rjeans/rotexign/analysis/smoothed_timing_curves.png

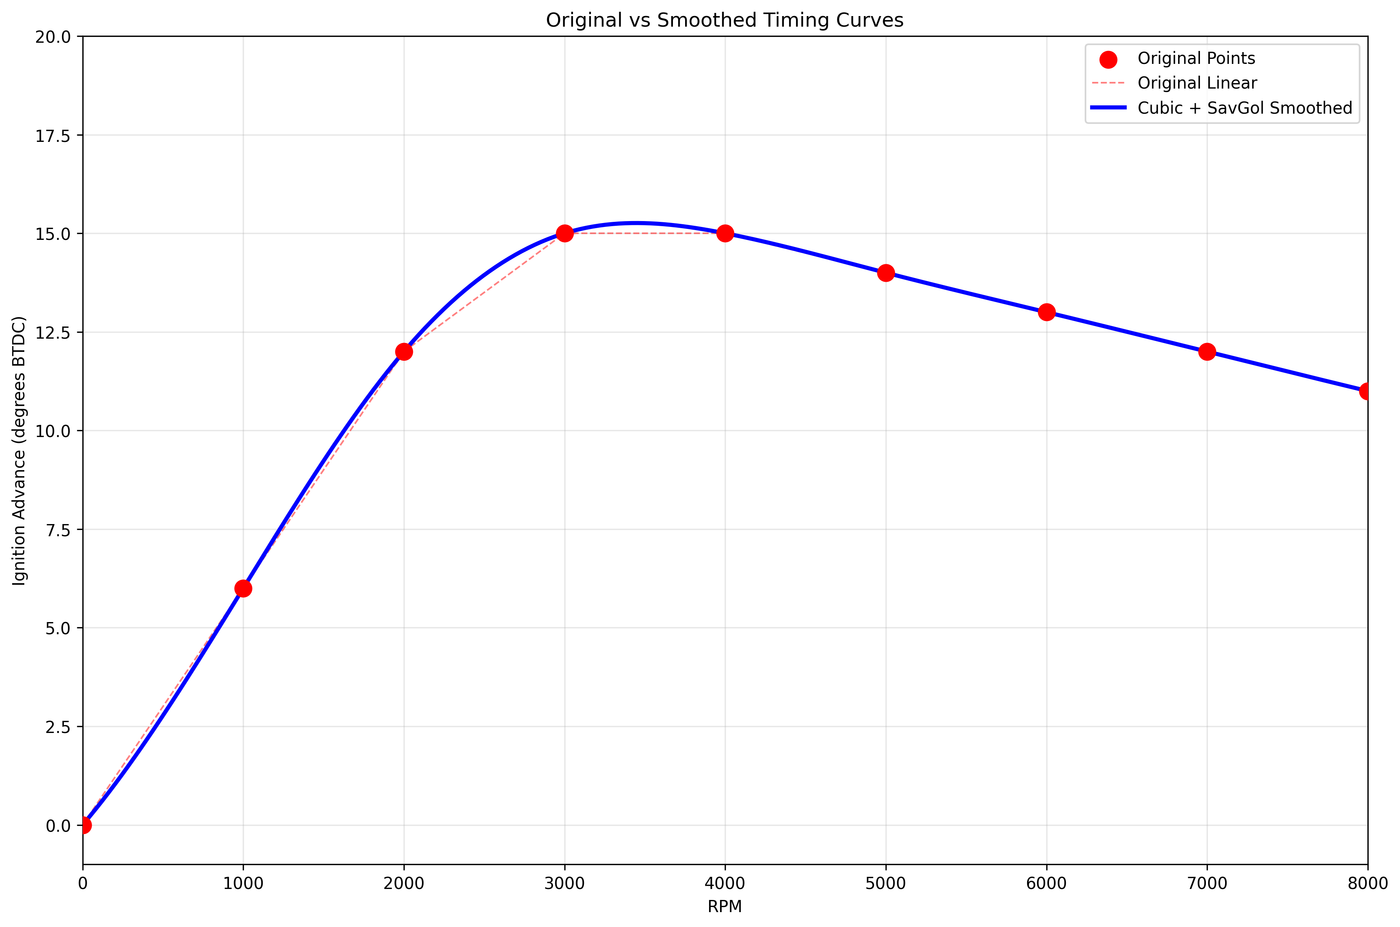
analysis/smoothed_timing_curves.png
