rjeans/rotexign/analysis/plot_data_verification.csv

rpm | advance_degrees | data_source
800 | 4.69 | plot_data
800 | 4.69 | plot_data
800 | 4.69 | plot_data
800 | 4.69 | plot_data
800 | 4.69 | plot_data
800 | 4.69 | plot_data
800 | 4.69 | plot_data
800 | 4.69 | plot_data
800 | 4.69 | plot_data
800 | 4.69 | plot_data
800 | 4.69 | plot_data
800 | 4.69 | plot_data
800 | 4.69 | plot_data
800 | 4.69 | plot_data
800 | 4.69 | plot_data
800 | 4.69 | plot_data
800 | 4.69 | plot_data
800 | 4.69 | plot_data
800 | 4.69 | plot_data
800 | 4.69 | plot_data
800 | 4.69 | plot_data
800 | 4.69 | plot_data
800 | 4.69 | plot_data
800 | 4.69 | plot_data
800 | 4.69 | plot_data
800 | 4.69 | plot_data
800 | 4.69 | plot_data
800 | 4.69 | plot_data
800 | 4.68 | plot_data
800 | 4.69 | plot_data
800 | 4.69 | plot_data
800 | 4.69 | plot_data
800 | 4.69 | plot_data
800 | 4.68 | plot_data
800 | 4.69 | plot_data
800 | 4.69 | plot_data
800 | 4.69 | plot_data
800 | 4.69 | plot_data
800 | 4.69 | plot_data
800 | 4.69 | plot_data
800 | 4.69 | plot_data
800 | 4.68 | plot_data
800 | 4.69 | plot_data
800 | 4.69 | plot_data
800 | 4.69 | plot_data
800 | 4.69 | plot_data
800 | 4.69 | plot_data
800 | 4.69 | plot_data
800 | 4.69 | plot_data
800 | 4.68 | plot_data
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
