rjeans/rotexign/analysis/timing_analyzer.py

#!/usr/bin/env python3
"""
VCD Timing Analyzer with Comprehensive Plotting
Measures trigger falling edge to spark falling edge timing
Generates timing curves, waveforms, and analysis plots with scatter points
"""
import sys
import csv
import numpy as np
import matplotlib
matplotlib.use('Agg')  # Use non-interactive backend
import matplotlib.pyplot as plt
from typing import List, Tuple, Dict

# Signal mappings for VCD parsing
# Updated to reflect inverted spark logic: LOW = dwell start, HIGH = spark
SIGNAL_MAPPINGS = {
    '0#': 'trigger_fall',
    '1#': 'trigger_rise',
    '0$': 'dwell_start',   # LOW = dwell start (coil charging)
    '1$': 'spark_fire',    # HIGH = spark (coil fires)
    '0!': 'trigger_fall',  # Legacy
    '1!': 'trigger_rise',  # Legacy
    '0"': 'dwell_start',   # Legacy - now dwell start
    '1"': 'spark_fire'     # Legacy - now spark fire
}

def parse_vcd_file(vcd_file: str) -> List[Tuple[int, str]]:
    """
    Parse the VCD file and extract signal changes.

    Args:
        vcd_file: Path to the VCD file.

    Returns:
        A list of tuples containing the time and event type.
    """
    signal_changes = []
    current_time = 0

    with open(vcd_file, 'r') as f:
        for line in f:
            line = line.strip()
            if line.startswith('#'):
                current_time = int(line[1:])
            elif line in SIGNAL_MAPPINGS:
                signal_changes.append((current_time, SIGNAL_MAPPINGS[line]))

    return signal_changes

def find_previous_event(signal_changes: List[Tuple[int, str]], start_index: int, event_type: str) -> int:
    """
    Find the most recent event of a given type before a specific index.

    Args:
        signal_changes: List of signal changes.
        start_index: Index to start searching backward from.
        event_type: The event type to search for.

    Returns:
        The time of the most recent event, or None if not found.
    """
    for j in range(start_index - 1, -1, -1):
        if signal_changes[j][1] == event_type:
            return signal_changes[j][0]
    return None

def calculate_rpm(period_ns: int, pulses_per_revolution: int = 2) -> float:
    """
    Calculate RPM from a period in nanoseconds.

    Args:
        period_ns: The period in nanoseconds.
        pulses_per_revolution: Number of pulses per revolution (default: 2).

    Returns:
        The calculated RPM.
    """
    period_us = period_ns / 1000.0
    return (60_000_000.0 / period_us) / pulses_per_revolution

def find_corresponding_dwell(signal_changes: List[Tuple[int, str]], spark_idx: int, spark_time: int) -> float:
    """
    Find the dwell start corresponding to a given spark event.

    Args:
        signal_changes: List of signal changes.
        spark_idx: Index of the spark event.
        spark_time: Time of the spark event.

    Returns:
        The dwell time in microseconds, or None if not found.
    """
    for k in range(spark_idx - 1, -1, -1):
        check_time, check_event = signal_changes[k]
        if spark_time - check_time > 200000000:  # Stop if too far back (200ms)
            break
        if check_event == 'dwell_start':
            spark_between = any(
                signal_changes[m][1] == 'spark_fire'
                for m in range(k + 1, spark_idx)
            )
            if not spark_between:
                return (spark_time - check_time) / 1000.0
    return None

def find_dwell_for_trigger(signal_changes: List[Tuple[int, str]], trigger_idx: int, spark_idx: int, spark_time: int, trigger_time: int) -> float:
    """
    Find dwell start after trigger, looking forward to next period.
    
    Args:
        signal_changes: List of signal changes.
        trigger_idx: Index of the trigger event.
        spark_idx: Index of the spark event.
        spark_time: Time of the spark event.
        trigger_time: Time of the trigger event.
    
    Returns:
        The dwell time in microseconds, or None if not found.
    """
    # Calculate expected next trigger time (rough estimate based on period)
    prev_trigger_time = find_previous_event(signal_changes, trigger_idx, 'trigger_fall')
    if prev_trigger_time is not None:
        period_ns = trigger_time - prev_trigger_time
        next_trigger_time = trigger_time + period_ns
    else:
        # Use a default period estimate
        next_trigger_time = trigger_time + 30000000  # ~30ms default
    
    # Look forward from current trigger to find dwell start
    for k in range(trigger_idx + 1, len(signal_changes)):
        check_time, check_event = signal_changes[k]
        
        # Stop if we've gone past the next trigger time
        if check_time > next_trigger_time:
            break
            
        if check_event == 'dwell_start':
            # Check if this dwell belongs to our spark
            if check_time < spark_time:
                return (spark_time - check_time) / 1000.0
    
    # If no dwell found in next period, pulse is missing
    return None

def find_trigger_pulse_width(signal_changes, trigger_fall_idx):
    """Find the trigger pulse width by looking for the next trigger_rise."""
    if trigger_fall_idx >= len(signal_changes) - 1:
        return None
    
    trigger_fall_time = signal_changes[trigger_fall_idx][0]
    
    for j in range(trigger_fall_idx + 1, min(len(signal_changes), trigger_fall_idx + 10)):
        check_time, check_event = signal_changes[j]
        if check_event == 'trigger_rise':
            return (check_time - trigger_fall_time) / 1000.0  # Return in microseconds
    return None

def analyze_vcd(vcd_file: str) -> Tuple[List[Dict], List[Dict]]:
    """
    Analyze VCD timing with simplified logic:
    1. Find trigger edge T0
    2. Find next trigger edge T1  
    3. Find next dwell start D0
    4. If T1 < D0 then missing, go to next trigger
    5. Find spark trailing edge S0
    6. Advance = S0 - T0, if S0 > T1 then subtract period (previous lobe)
    """
    signal_changes = parse_vcd_file(vcd_file)
    print(f"Found {len(signal_changes)} signal changes")

    timing_events = []
    missing_spark_events = []
    
    i = 0
    while i < len(signal_changes):
        time, event = signal_changes[i]
        
        if event != 'trigger_fall':
            i += 1
            continue
            
        # Step 1: Found trigger edge T0
        T0 = time
        
        # Step 1a: Find PREVIOUS trigger edge T-1 for period calculation
        T_prev = None
        for k in range(i - 1, -1, -1):
            if signal_changes[k][1] == 'trigger_fall':
                T_prev = signal_changes[k][0]
                break
        
        if T_prev is None:
            i += 1
            continue  # No previous trigger, skip first trigger
            
        # Calculate period and RPM from T-1 to T0
        period_ns = T0 - T_prev
        rpm = calculate_rpm(period_ns)
        
        # Step 2: Find next trigger edge T1 (for detecting missing sparks)
        T1 = None
        j = i + 1
        while j < len(signal_changes):
            check_time, check_event = signal_changes[j]
            if check_event == 'trigger_fall':
                T1 = check_time
                break
            j += 1
        
        if T1 is None:
            i += 1
            continue  # No next trigger found
        
        # Step 3: Find next dwell start D0
        D0 = None
        k = i + 1
        while k < len(signal_changes):
            check_time, check_event = signal_changes[k]
            if check_time >= T1:
                break  # Gone past next trigger
            if check_event == 'dwell_start':
                D0 = check_time
                break
            k += 1
        
        # Step 4: Check if T1 < D0 (missing spark)
        if D0 is None or T1 < D0:
            missing_spark_events.append({
                'time_sec': T0 / 1e9,
                'rpm': rpm,
                'reason': 'Missing spark - no dwell before next trigger'
            })
            i += 1
            continue
            
        # Step 5: Find spark trailing edge S0
        S0 = None
        dwell_time = None
        m = k + 1
        while m < len(signal_changes):
            check_time, check_event = signal_changes[m]
            # Don't stop at T1 - spark might be in next period for previous-lobe
            if (check_time - T0) > 200000000:  # 200ms max search
                break
            if check_event == 'spark_fire':
                S0 = check_time
                dwell_time = (S0 - D0) / 1000.0  # microseconds
                break
            m += 1
            
        if S0 is None:
            missing_spark_events.append({
                'time_sec': T0 / 1e9,
                'rpm': rpm,
                'reason': 'No spark found after dwell start'
            })
            i += 1
            continue
            
        # Step 6: Calculate advance
        spark_delay_us = (S0 - T0) / 1000.0
        period_us = period_ns / 1000.0
        
        # Check if previous-lobe timing (S0 > T1)
        if S0 > T1:
            is_previous_lobe = True
            # Subtract period to get actual timing within cycle
            actual_delay_us = spark_delay_us - period_us
        else:
            is_previous_lobe = False
            actual_delay_us = spark_delay_us
            
        # Convert to degrees (180° per trigger period)
        degrees_per_us = 180.0 / period_us
        delay_degrees = actual_delay_us * degrees_per_us
        advance_degrees = 47.0 - delay_degrees
        
        # Only keep valid measurements
        if 0 <= advance_degrees <= 47:
            # Find trigger pulse width
            trigger_pulse_width_us = None
            for n in range(i + 1, min(i + 10, len(signal_changes))):
                if signal_changes[n][1] == 'trigger_rise':
                    trigger_pulse_width_us = (signal_changes[n][0] - T0) / 1000.0
                    break
                    
            timing_events.append({
                'trigger_ns': T0,  # VCD timestamp for trigger
                'spark_ns': S0,    # VCD timestamp for spark
                'time_sec': T0 / 1e9,
                'rpm': rpm,
                'delay_us': actual_delay_us,
                'delay_degrees': delay_degrees,
                'advance_degrees': advance_degrees,
                'dwell_us': dwell_time,
                'trigger_pulse_width_us': trigger_pulse_width_us,
                'is_previous_lobe': is_previous_lobe
            })
        
        i += 1

    print(f"\nFound {len(timing_events)} timing measurements")
    print(f"Found {len(missing_spark_events)} missing spark events")

    return timing_events, missing_spark_events

def get_theoretical_curve(rpm_range):
    """
    Load and interpolate the Cubic + SavGol smoothed timing curve.
    Falls back to original linear interpolation if file not found.
    """
    try:
        # Try to load the Cubic + SavGol curve from CSV
        import os
        curve_file = 'timing_curve_cubic.csv'
        
        if os.path.exists(curve_file):
            # Load the smoothed curve
            curve_rpm = []
            curve_advance = []
            
            with open(curve_file, 'r') as f:
                reader = csv.reader(f)
                next(reader)  # Skip comment line
                next(reader)  # Skip header
                for row in reader:
                    curve_rpm.append(float(row[0]))
                    curve_advance.append(float(row[1]))
            
            # Interpolate to match the requested RPM range
            from scipy.interpolate import interp1d
            f_interp = interp1d(curve_rpm, curve_advance, kind='linear', 
                               bounds_error=False, fill_value='extrapolate')
            safe_curve = f_interp(rpm_range)
            safe_curve = np.clip(safe_curve, 0, 20)
            
            print("Using Cubic + SavGol smoothed curve for comparison")
            return safe_curve
            
    except (FileNotFoundError, ImportError) as e:
        print(f"Using original linear curve (could not load smoothed curve: {e})")
    
    # Fallback to original linear interpolation
    safe_curve = []
    for rpm in rpm_range:
        if rpm <= 1000:
            safe_adv = rpm * 0.006  # 0-6° from 0-1000 RPM
        elif rpm <= 2000:
            safe_adv = 6 + (rpm - 1000) * 0.006  # 6-12° from 1000-2000 RPM
        elif rpm <= 3000:
            safe_adv = 12 + (rpm - 2000) * 0.003  # 12-15° from 2000-3000 RPM
        elif rpm <= 4000:
            safe_adv = 15  # Hold at 15°
        elif rpm <= 5000:
            safe_adv = 15 - (rpm - 4000) * 0.001  # 15-14° from 4000-5000 RPM
        elif rpm <= 6000:
            safe_adv = 14 - (rpm - 5000) * 0.001  # 14-13° from 5000-6000 RPM
        else:
            safe_adv = 13 - (rpm - 6000) * 0.001  # 13-12° from 6000-7000 RPM
        
        safe_curve.append(max(0, safe_adv))
    
    return np.array(safe_curve)

def generate_csv_output(timing_events, missing_spark_events):
    """Generate CSV files with timing data."""
    
    # Main timing analysis CSV
    with open('wokwi-logic-analysis.csv', 'w', newline='') as f:
        writer = csv.writer(f)
        
        # Calculate theoretical curve for comparison
        rpms = [event['rpm'] for event in timing_events]
        if rpms:
            rpm_range = np.linspace(min(rpms), max(rpms), 100)
            safe_curve = get_theoretical_curve(rpm_range)
            
            # Create lookup for theoretical values
            safe_interp = np.interp(rpms, rpm_range, safe_curve)
        else:
            safe_interp = []
        
        # Header
        writer.writerow([
            'trigger_ns', 'spark_ns', 'time_sec', 'rpm', 'period_us', 'delay_us', 'delay_degrees', 'advance_degrees',
            'dwell_us', 'trigger_pulse_width_us', 'is_previous_lobe', 'safe_advance',
            'error_degrees', 'error_percent'
        ])
        
        # Data rows
        for i, event in enumerate(timing_events):
            safe_val = safe_interp[i] if i < len(safe_interp) else 0.0
            actual_val = event['advance_degrees']
            error_degrees = actual_val - safe_val
            # Calculate percentage error relative to safe value (or use 1 if safe value is 0)
            if safe_val != 0:
                error_percent = (error_degrees / safe_val) * 100
            else:
                error_percent = error_degrees * 100  # If safe is 0, treat error as percentage
            
            # Calculate period in microseconds (60,000,000 / (rpm * 2))
            period_us = 60_000_000 / (event['rpm'] * 2) if event['rpm'] > 0 else 0
            
            writer.writerow([
                f"{event['trigger_ns']}",
                f"{event['spark_ns']}",
                f"{event['time_sec']:.3f}",
                f"{event['rpm']:.0f}",
                f"{period_us:.1f}",
                f"{event['delay_us']:.1f}",
                f"{event['delay_degrees']:.2f}",
                f"{event['advance_degrees']:.2f}",
                f"{event['dwell_us']:.1f}" if event['dwell_us'] is not None else "N/A",
                f"{event['trigger_pulse_width_us']:.1f}" if event['trigger_pulse_width_us'] is not None else "N/A",
                event['is_previous_lobe'],
                f"{safe_val:.2f}",
                f"{error_degrees:.2f}",
                f"{error_percent:.1f}"
            ])
    
    # Missing sparks CSV
    with open('wokwi-logic-missing-sparks.csv', 'w', newline='') as f:
        writer = csv.writer(f)
        writer.writerow(['time_sec', 'rpm', 'reason'])
        
        for event in missing_spark_events:
            writer.writerow([
                f"{event['time_sec']:.3f}",
                f"{event['rpm']:.0f}",
                event['reason']
            ])

def create_timing_vs_rpm_plot(timing_events):
    """Create ignition timing vs RPM plot with scatter points."""
    if not timing_events:
        print("No timing events to plot")
        return
    
    # Show ALL data - no filtering
    all_advances = [event['advance_degrees'] for event in timing_events]
    all_rpms = [event['rpm'] for event in timing_events]
    
    print(f"Advance range: {min(all_advances):.1f}° to {max(all_advances):.1f}°")
    print(f"RPM range: {min(all_rpms):.0f} to {max(all_rpms):.0f}")
    
    # Use all events - no filtering
    rpms = np.array(all_rpms)
    advances = np.array(all_advances)
    
    # Output plot data to CSV for verification
    with open('plot_data_verification.csv', 'w', newline='') as f:
        writer = csv.writer(f)
        writer.writerow(['rpm', 'advance_degrees', 'data_source'])
        for event in timing_events:
            writer.writerow([
                f"{event['rpm']:.0f}",
                f"{event['advance_degrees']:.2f}",
                'plot_data'
            ])
    
    print(f"Plot data written to plot_data_verification.csv ({len(timing_events)} points)")
    
    # Create figure with two subplots
    fig, (ax1, ax2) = plt.subplots(2, 1, figsize=(12, 10))
    
    # Generate theoretical curve
    rpm_range = np.linspace(0, 8000, 100)
    safe_curve = get_theoretical_curve(rpm_range)
    
    # Upper plot: Timing vs RPM with scatter points
    ax1.scatter(rpms, advances, alpha=0.3, s=20, c='lightblue', label='Individual measurements', zorder=1)
    
    # Calculate measured curve (binned averages with error bars)
    # Start binning from the minimum measured RPM (rounded down to nearest 50)
    min_rpm = min(rpms) if rpms.size > 0 else 0
    min_bin = (min_rpm // 50) * 50
    rpm_bins = np.arange(min_bin, 8000, 100)
    bin_centers = rpm_bins[:-1] + 50
    bin_means = []
    bin_stds = []
    
    for i in range(len(rpm_bins)-1):
        mask = (rpms >= rpm_bins[i]) & (rpms < rpm_bins[i+1])
        if np.sum(mask) > 0:
            bin_means.append(np.mean(advances[mask]))
            bin_stds.append(np.std(advances[mask]))
        else:
            bin_means.append(np.nan)
            bin_stds.append(np.nan)
    
    # Remove NaN values for plotting
    valid_mask = ~np.isnan(bin_means)
    valid_centers = bin_centers[valid_mask]
    valid_means = np.array(bin_means)[valid_mask]
    valid_stds = np.array(bin_stds)[valid_mask]
    
    # Output binned data to CSV for verification
    with open('binned_plot_data.csv', 'w', newline='') as f:
        writer = csv.writer(f)
        writer.writerow(['rpm_bin_center', 'mean_advance_degrees', 'std_advance_degrees', 'data_source'])
        for i in range(len(valid_centers)):
            writer.writerow([
                f"{valid_centers[i]:.0f}",
                f"{valid_means[i]:.2f}",
                f"{valid_stds[i]:.2f}",
                'binned_plot_data'
            ])
    
    print(f"Binned plot data written to binned_plot_data.csv ({len(valid_centers)} bins)")
    
    # Plot curves
    ax1.plot(rpm_range, safe_curve, '--', color='orange', linewidth=2, label='Target (Cubic+SavGol)')
    ax1.errorbar(valid_centers, valid_means, yerr=valid_stds, fmt='o-', 
                color='blue', capsize=3, capthick=1, linewidth=2, 
                label='Measured (±1σ)', zorder=3)
    
    ax1.set_xlabel('RPM')
    ax1.set_ylabel('Ignition Advance (degrees BTDC)')
    ax1.set_title('Ignition Timing vs RPM')
    ax1.grid(True, alpha=0.3)
    ax1.legend()
    ax1.set_xlim(0, 8000)
    # Set y-axis limits based on actual data range (with some padding)
    if timing_events:
        y_min = min(all_advances) - 1
        y_max = max(all_advances) + 1
        ax1.set_ylim(y_min, y_max)
    else:
        ax1.set_ylim(-5, 25)
    
    # Lower plot: Duty Cycle and Dwell Time vs RPM
    # Filter out events with None dwell_us values
    valid_events = [event for event in timing_events if event['dwell_us'] is not None]
    dwells = np.array([event['dwell_us'] for event in valid_events])
    valid_rpms = np.array([event['rpm'] for event in valid_events])
    
    # Calculate duty cycle: dwell_time / period_time * 100
    periods_us = 60_000_000 / (valid_rpms * 2)  # Period between triggers in microseconds
    duty_cycles = (dwells / periods_us) * 100
    
    # Create twin axis for dwell time
    ax2_twin = ax2.twinx()
    
    # Plot duty cycle (left axis)
    ax2.scatter(valid_rpms, duty_cycles, alpha=0.3, s=20, c='lightgreen', label='Individual duty cycle', zorder=1)
    
    # Calculate duty cycle statistics by RPM bins
    duty_means = []
    duty_stds = []
    dwell_means = []
    dwell_stds = []
    
    for i in range(len(rpm_bins)-1):
        mask = (valid_rpms >= rpm_bins[i]) & (valid_rpms < rpm_bins[i+1])
        if np.sum(mask) > 0:
            duty_means.append(np.mean(duty_cycles[mask]))
            duty_stds.append(np.std(duty_cycles[mask]))
            dwell_means.append(np.mean(dwells[mask]))
            dwell_stds.append(np.std(dwells[mask]))
        else:
            duty_means.append(np.nan)
            duty_stds.append(np.nan)
            dwell_means.append(np.nan)
            dwell_stds.append(np.nan)
    
    # Remove NaN values for plotting
    valid_duty_mask = ~np.isnan(duty_means)
    valid_duty_centers = bin_centers[valid_duty_mask]
    valid_duty_means = np.array(duty_means)[valid_duty_mask]
    valid_duty_stds = np.array(duty_stds)[valid_duty_mask]
    valid_dwell_means = np.array(dwell_means)[valid_duty_mask]
    valid_dwell_stds = np.array(dwell_stds)[valid_duty_mask]
    
    # Plot duty cycle trend line (left axis)
    ax2.errorbar(valid_duty_centers, valid_duty_means, yerr=valid_duty_stds,
                fmt='o-', color='green', capsize=3, capthick=1, linewidth=2,
                label='Mean duty cycle ± std dev', zorder=3)
    
    # Plot dwell time scatter (right axis)
    ax2_twin.scatter(valid_rpms, dwells/1000, alpha=0.3, s=20, c='lightcoral', label='Individual dwell time', zorder=1)
    
    # Plot dwell time trend line (right axis)
    ax2_twin.errorbar(valid_duty_centers, valid_dwell_means/1000, yerr=valid_dwell_stds/1000,
                     fmt='s-', color='red', capsize=3, capthick=1, linewidth=2,
                     label='Mean dwell time ± std dev', zorder=3)
    
    # Add reference lines
    ax2.axhline(y=40, color='orange', linestyle='--', alpha=0.7, label='40% max duty cycle')
    ax2_twin.axhline(y=3, color='blue', linestyle='--', alpha=0.7, label='Target 3ms dwell')
    
    # Configure axes
    ax2.set_xlabel('RPM')
    ax2.set_ylabel('Duty Cycle (%)', color='green')
    ax2_twin.set_ylabel('Dwell Time (ms)', color='red')
    ax2.set_title('Duty Cycle and Dwell Time vs RPM')
    ax2.grid(True, alpha=0.3)
    
    # Configure colors
    ax2.tick_params(axis='y', labelcolor='green')
    ax2_twin.tick_params(axis='y', labelcolor='red')
    
    # Legends
    ax2.legend(loc='upper left')
    ax2_twin.legend(loc='upper right')
    
    ax2.set_xlim(0, 8000)
    ax2.set_ylim(0, 50)  # 0-50% duty cycle
    ax2_twin.set_ylim(0, 5)  # 0-5ms dwell time
    
    plt.tight_layout()
    plt.savefig('timing_vs_rpm.png', dpi=300, bbox_inches='tight')
    plt.close()
    
    print("Generated timing_vs_rpm.png")

def create_waveforms_plot(timing_events):
    """Create timing waveforms plot showing sample waveforms at different RPMs."""
    if not timing_events:
        print("No timing events to plot")
        return
    
    # Select representative RPM points
    rpms = np.array([event['rpm'] for event in timing_events])
    target_rpms = [1000, 2000, 4000, 6000]
    
    fig, axes = plt.subplots(len(target_rpms), 1, figsize=(12, 8))
    if len(target_rpms) == 1:
        axes = [axes]
    
    for i, target_rpm in enumerate(target_rpms):
        # Find closest measurement to target RPM
        closest_idx = np.argmin(np.abs(rpms - target_rpm))
        event = timing_events[closest_idx]
        actual_rpm = event['rpm']
        
        # Calculate period and timing
        period_us = 60_000_000 / (actual_rpm * 2)  # Period between triggers
        delay_us = event['delay_us']
        dwell_us = event['dwell_us'] if event['dwell_us'] else 3000
        trigger_pulse_width_us = event['trigger_pulse_width_us'] if event['trigger_pulse_width_us'] else 500
        
        # Create time axis (show ~2.5 periods)
        time_span_us = period_us * 2.5
        time_us = np.linspace(0, time_span_us, 1000)
        
        # Generate trigger signal (normally HIGH, brief LOW pulse at trigger times)
        trigger_signal = np.ones_like(time_us) * 3
        for trigger_time in [0, period_us, period_us * 2]:
            if trigger_time < time_span_us:
                # Add trigger falling edge (measured pulse width from VCD data)
                pulse_start = trigger_time
                pulse_end = trigger_time + trigger_pulse_width_us
                pulse_mask = (time_us >= pulse_start) & (time_us <= pulse_end)
                trigger_signal[pulse_mask] = 0
        
        # Generate spark signal (normally HIGH, LOW during dwell, HIGH at spark)
        spark_signal = np.ones_like(time_us) * 2  # Start HIGH (no dwell)
        for trigger_time in [0, period_us, period_us * 2]:
            spark_time = trigger_time + delay_us
            dwell_start_time = spark_time - dwell_us
            
            if spark_time < time_span_us and dwell_start_time >= 0:
                # Add dwell period (LOW = coil charging)
                dwell_mask = (time_us >= dwell_start_time) & (time_us < spark_time)
                spark_signal[dwell_mask] = 0
                
                # Spark event is the rising edge at spark_time (end of dwell)
                # The signal returns to HIGH after dwell ends
        
        # Plot signals
        ax = axes[i]
        ax.plot(time_us / 1000, trigger_signal, 'b-', linewidth=2, label='Trigger')
        ax.plot(time_us / 1000, spark_signal, 'r-', linewidth=2, label='Spark')
        
        # Add timing annotations
        advance_angle = event['advance_degrees']
        btdc_label = f"{advance_angle:.1f}° BTDC"
        dwell_label = f"{dwell_us/1000:.1f} ms dwell"
        
        ax.text(0.02, 0.95, btdc_label, transform=ax.transAxes, 
                bbox=dict(boxstyle='round', facecolor='yellow', alpha=0.7),
                verticalalignment='top')
        ax.text(0.02, 0.80, dwell_label, transform=ax.transAxes,
                bbox=dict(boxstyle='round', facecolor='lightgreen', alpha=0.7),
                verticalalignment='top')
        
        ax.set_ylabel('Signal')
        ax.set_title(f'{int(actual_rpm)} RPM (Same-lobe)' if not event['is_previous_lobe'] 
                    else f'{int(actual_rpm)} RPM (Previous-lobe) - {advance_angle:.1f}° advance - GOOD')
        ax.grid(True, alpha=0.3)
        ax.set_ylim(-0.5, 3.5)
        
        if i == 0:
            ax.legend()
        if i == len(target_rpms) - 1:
            ax.set_xlabel('Time (ms)')
    
    plt.suptitle('Ignition Timing Waveforms')
    plt.tight_layout()
    plt.savefig('timing_waveforms.png', dpi=300, bbox_inches='tight')
    plt.close()
    
    print("Generated timing_waveforms.png")


if __name__ == "__main__":
    if len(sys.argv) < 2:
        print("Usage: python timing_analyzer.py <vcd_file>")
        sys.exit(1)
    
    vcd_file = sys.argv[1]
    timing_events, missing_spark_events = analyze_vcd(vcd_file)
    
    # Generate CSV output files
    generate_csv_output(timing_events, missing_spark_events)
    print("Generated CSV files: wokwi-logic-analysis.csv, wokwi-logic-missing-sparks.csv")
    
    # Generate plots
    create_timing_vs_rpm_plot(timing_events)
    create_waveforms_plot(timing_events)
    
    print("\nAnalysis complete! Generated:")
    print("- CSV files with timing data")
    print("- timing_vs_rpm.png (with scatter points)")
    print("- timing_waveforms.png")
    
    # Summary statistics
    if timing_events:
        rpms = [event['rpm'] for event in timing_events]
        advances = [event['advance_degrees'] for event in timing_events]
        print(f"\nSummary:")
        print(f"RPM range: {min(rpms):.0f} - {max(rpms):.0f}")
        print(f"Advance range: {min(advances):.1f}° - {max(advances):.1f}° BTDC")
        print(f"Timing measurements: {len(timing_events)}")
        print(f"Missing spark events: {len(missing_spark_events)}")
