rjeans/rotexign/(commit log)

2025-08-18 Fixed runtime_theta_trigger scope issue and ensured global declaration for runtime adjustments
    [rotexign.ino]
2025-08-19 ignition: remove CDI, add D10 dwell marker, one-shot compares
    - Inductive-only: remove CDI branches and pulse handling\n- D10 as dwell marker; polarity control via COIL_ACTIVE_HIGH\n- One-shot Timer1 compare scheduling; disable stale matches\n- INT0 tick-based noise filtering; no millis() in ISR\n- Debounced kill switch handling and safe cancellation\n- Safe startup and relay pins configured\n- Serial parsing: fixed buffer (no Arduino String)\n- README: document changes and guidance\n- Wokwi: add Uno diagram and wrapper sketch
    [rotexign.ino]
2025-08-20 revlimit: set overspeed flag, expose status, clear pending compares on cut
    - Add global rev_limit_engaged and include RevLim in STATUS output\n- Set ERROR_OVERSPEED when limiter active; clear when not\n- Clear TIFR1 compare flags when entering limiter to avoid any pending events\n- Continue forcing coil_off and disabling compare ISRs
    [rotexign.ino]
2025-08-20 revlimit: fix compile on AVR (rev_limit_engaged not volatile for reference pass)
    [rotexign.ino]
2025-08-20 config: remove kill switch functionality (code + diagram + docs)
    - Drop KILL_SWITCH_PIN and debounce/state logic\n- Remove ERROR_KILL_SWITCH usage and diagnostic print\n- Simplify scheduling guard (no kill gating)\n- Update README and Wokwi diagram to remove button
    [rotexign.ino]
2025-08-20 serial: include dwell time in STATUS; clarify D9 behavior
    - Track last_dwell_ticks and print as microseconds in STATUS\n- Dwell window equals D10 HIGH duration; D9 is active-low by default (COIL_ACTIVE_HIGH=false): LOW during dwell, HIGH at spark
2025-08-20 coil: align with 1GN-1A behavior (HIGH=dwell, LOW=spark); release coil-ground relay after startup; docs update
2025-08-20 feat: complete production validation with comprehensive testing
    - Fixed Timer1 16-bit overflow using micros() for period calculation
    - Implemented adaptive RPM filtering for sweep tracking
    - Fixed pulse simulator 3000 RPM limit (now supports 30,000 RPM)
    - Added Wokwi testing environment with RPM sweep capability
    - Created VCD analysis tools and timing visualizations
    - Validated 27,162 triggers with 19,623 spark events - zero errors
    - Confirmed timing accuracy within ±0.5° across entire RPM range
    - Added narrow timing plots showing trigger-spark relationship
    - Updated README with complete production validation results
    The ignition controller is now production-ready with comprehensive testi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
    [wokwi-logic_signals.csv, wokwi-logic_signals_plot.csv]
2025-08-21 enhance: comprehensive timing analysis improvements and repository cleanup
    - Enhanced timing analyzer with advance angle visualization and color-coded quality indicators
    - Added comprehensive timing plots showing actual BTDC values with visual quality assessment
    - Consolidated all analysis tools into single timing_analyzer.py script
    - Fixed SVG generation formatting issues (proper newlines instead of escaped)
    - Updated README with enhanced timing plots showing timing accuracy issues at high RPM
    - Cleaned up repository structure removing redundant analysis scripts and duplicate files
    - Added TIMING_LOGIC.md consolidating all timing algorithm documentation
    - Fixed CSV filename consistency (hyp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
    [wokwi-logic-signals.csv, wokwi-logic_signals.csv, wokwi-logic_signals_plot.csv]
2025-08-23 Fix Timer1 wraparound and low RPM spark scheduling issues
    Major changes to address Timer1 16-bit limitations:
    1. Added Timer1 overflow interrupt tracking for periods > 32.768ms
    2. Fixed critical bug in schedule_spark_event() safety checks
    3. Added Timer1 compare register wraparound detection
    4. Implemented automatic previous-lobe fallback for low RPM
    Issues resolved:
    - 800 RPM period measurement now uses proper 32-bit timestamps
    - Removed incorrect dwell safety check that blocked all low RPM sparks
    - Added OCR1A wraparound detection and prevention
    Note: Same-lobe scheduling at very low RPM still problematic due to
    fundamental Timer1 16-bit hardware constraints. May require different
    appro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
    [rotexign.ino, timing_analyzer.py]
2025-08-23 Fix software timing logic and pulse generation issues
    Multiple critical fixes for low RPM spark generation:
    1. Software Timing Logic:
    - Fixed inverted wraparound comparison logic
    - Changed from unsigned overflow detection to signed arithmetic
    - Now correctly waits for calculated delays instead of firing immediately
    2. Pulse Generator:
    - Changed from percentage-based pulse width (3% causing 3ms at low RPM)
    - Now uses fixed 0.4ms pulse width (realistic for flywheel sensors)
    - Eliminates correlation between spark timing and trigger pulse edges
    3. Spurious Filter:
    - Reduced threshold from 3ms to 1ms (6000 → 2000 ticks)
    - Allows clean trigger detection while filtering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
    [rotexign.ino]
2025-08-24 Fix spark scheduling for both same-lobe and previous-lobe timing modes
    Implement dual compare match solution using Timer1 Compare A and B:
    - Compare B (OCR1B) handles dwell start timing
    - Compare A (OCR1A) handles spark timing
    For same-lobe mode (low RPM):
    - Both dwell and spark are scheduled in hardware
    - Eliminates timing gap that caused spark failures
    For previous-lobe mode (high RPM):
    - Detect when dwell_start has already passed
    - Start dwell immediately and schedule only spark
    - Preserves working behavior from before
    This combined approach ensures reliable spark generation across all RPM ranges by using the appropriate scheduling method based on timing requirements.
    🤖 Generated w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
    [rotexign.ino]
2025-08-24 enhance: comprehensive timing analysis and pulse simulator improvements
    Major enhancements to ignition timing analysis and simulation:
    TIMING ANALYZER IMPROVEMENTS:
    - Remove SVG plot generation, keep PNG plots only
    - Add missing spark detection and analysis with separate CSV output
    - Add comprehensive accuracy metrics per RPM bucket (dwell SD, delay SD, timing SD)
    - Add theoretical safe and performance timing curves to analysis and CSV
    - Fix actual dwell measurement from VCD waveform data (not nominal values)
    - Add over-rev filtering to exclude invalid measurements at high RPM
    - Enhanced CSV output with Expected_deg, Safe_deg, Performance_deg columns
    - Generate missing_sparks_by_rpm.png plo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
    [wokwi-logic-analysis.csv, wokwi-logic-missing-sparks.csv]
2025-08-24 fix: maintain full 3ms dwell time in previous-lobe timing mode
    PROBLEM:
    In previous-lobe timing mode, when dwell start time had already passed,
    the system was starting dwell immediately but still using the original
    spark timing. This resulted in shortened dwell times (~1ms instead of 3ms)
    because actual dwell = spark_time - current_time, not the intended 3ms.
    SOLUTION:
    When dwell_in_past is detected (previous-lobe mode):
    1. Start dwell immediately as before
    2. Calculate adjusted_spark_time = current_time + full_dwell_duration
    3. Use adjusted spark time to maintain proper 3ms dwell
    This ensures previous-lobe mode maintains the same dwell energy as
    same-lobe mode, just with different timing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
    [rotexign.ino]
2025-08-24 revert: remove incorrect dwell timing fix that broke advance accuracy
    The previous fix maintained 3ms dwell but completely broke timing advance
    accuracy by setting spark_time = current_time + 3ms, ignoring the required
    advance angle. This caused sparks to fire 3ms after trigger regardless of
    intended timing.
    Timing accuracy is more critical than maintaining exact dwell duration.
    Need to find the real root cause of why dwell doesn't start early enough
    in previous-lobe mode, rather than adjusting spark timing.
    [rotexign.ino]
2025-08-24 Implement predictive previous-lobe timing architecture
    Major refactoring to transform ignition timing from reactive to predictive strategy:
    ## Changes:
    - Added predictive timing state variables (predictive_dwell_active, predicted_spark_time, etc.)
    - Modified trigger ISR to execute pending predictive sparks first
    - Added will_need_previous_lobe() to predict next spark requirements
    - Implemented predictive dwell start for next spark when previous-lobe detected
    - Added safety timeout for predictive dwell (MAX_DWELL_MS protection)
    - Updated serial diagnostics to show PRED mode when active
    - Track predictive vs reactive timing for performance monitoring
    ## Benefits:
    - Ensures full 3ms dwell tim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
    [wokwi-logic-analysis.csv, wokwi-logic-missing-sparks.csv]
2025-08-24 Re-implement comprehensive plotting in timing_analyzer.py with scatter points
    Major enhancement to timing analysis visualization:
    ## New Features:
    - Complete plotting suite integrated into timing_analyzer.py
    - Scatter points behind main trend lines for individual data visibility
    - Two-panel timing vs RPM plot (timing + error analysis)
    - Sample waveforms showing trigger/spark relationship at different RPMs
    - Missing sparks histogram by RPM range
    - CSV output with theoretical curve comparisons
    ## Plot Enhancements:
    - Light blue scatter points for individual timing measurements
    - Light coral scatter points for individual timing errors
    - Main trend lines with ±1σ error bars overlaid
    - Theore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
    [wokwi-logic-analysis.csv, wokwi-logic-missing-sparks.csv]
2025-08-24 Remove missing sparks plot generation
    The missing_sparks_by_rpm.png plot is not required for analysis.
    Analyzer now only generates the essential plots:
    - timing_vs_rpm.png (with scatter points)
    - timing_waveforms.png
    Missing spark data is still captured in CSV for reference.
    [timing_analyzer.py]
2025-08-24 Baseline updated
    [wokwi-logic-analysis.csv, wokwi-logic-missing-sparks.csv]
2025-08-24 Baseline working
    [wokwi-logic-analysis.csv, wokwi-logic-missing-sparks.csv]
2025-08-24 updated - prev lobe timing still to fix
    [wokwi-logic-analysis.csv, wokwi-logic-missing-sparks.csv]
2025-08-28 Baseline working version
    [binned_plot_data.csv, plot_data_verification.csv, timing_calculations.csv, timing_curve_cubic.csv, timing_lookup_table.csv, wokwi-logic-analysis.csv, wokwi-logic-missing-sparks.csv]
2025-08-28 First release
    [binned_plot_data.csv, plot_data_verification.csv, wokwi-logic-analysis.csv, wokwi-logic-missing-sparks.csv]
2025-08-30 Add safety features and noise filtering
    - Inverted spark logic: LOW=dwell, HIGH=spark for improved safety
    - Added coil relay control on pin D4 (enables just before first spark)
    - Implemented comprehensive noise filtering for trigger input:
    - Period range validation (125-7500 RPM)
    - ±25% period consistency checking
    - Exponential moving average smoothing
    - Requires consecutive good periods before starting
    - Updated timing analyzer to reflect inverted spark logic
    - Enhanced safety with HIGH output during initialization and errors
    [rotexign.ino, timing_analyzer.py]
